abrahanlp/Nixie_Clock/Docu/reloj-nixie-proto-work.jpg

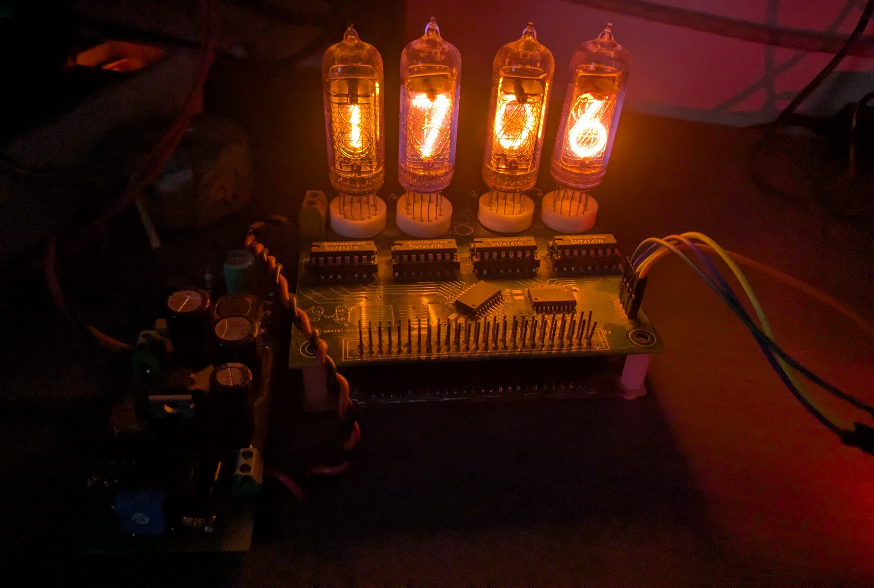
Docu/reloj-nixie-proto-work.jpg
