abrahanlp/Nixie_Clock/Docu/74141-and-nixies.jpg

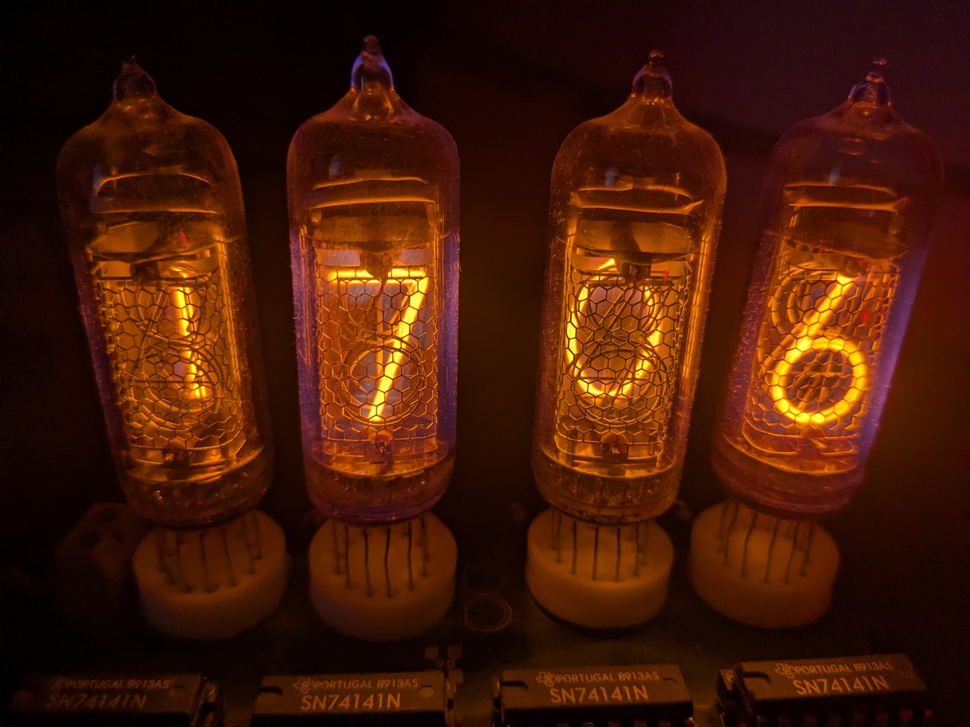
Docu/74141-and-nixies.jpg
