abrahanlp/Nixie_Clock/README.md

# Nixie_Clock
 Nixie display clock custom Arduino based.
