abrahanlp/Nixie_Clock/Docu/Nixie-Clock-diagram.png

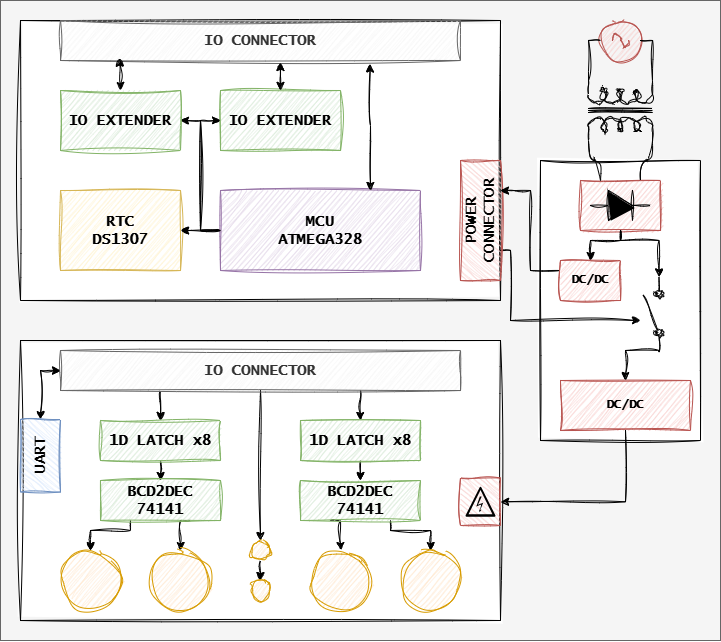
Docu/Nixie-Clock-diagram.png
