abrahanlp/Nixie_Clock/Hardware/MCU/MCU.brd

## EAGLE design Hardware/MCU/MCU.brd (2024-10-26)

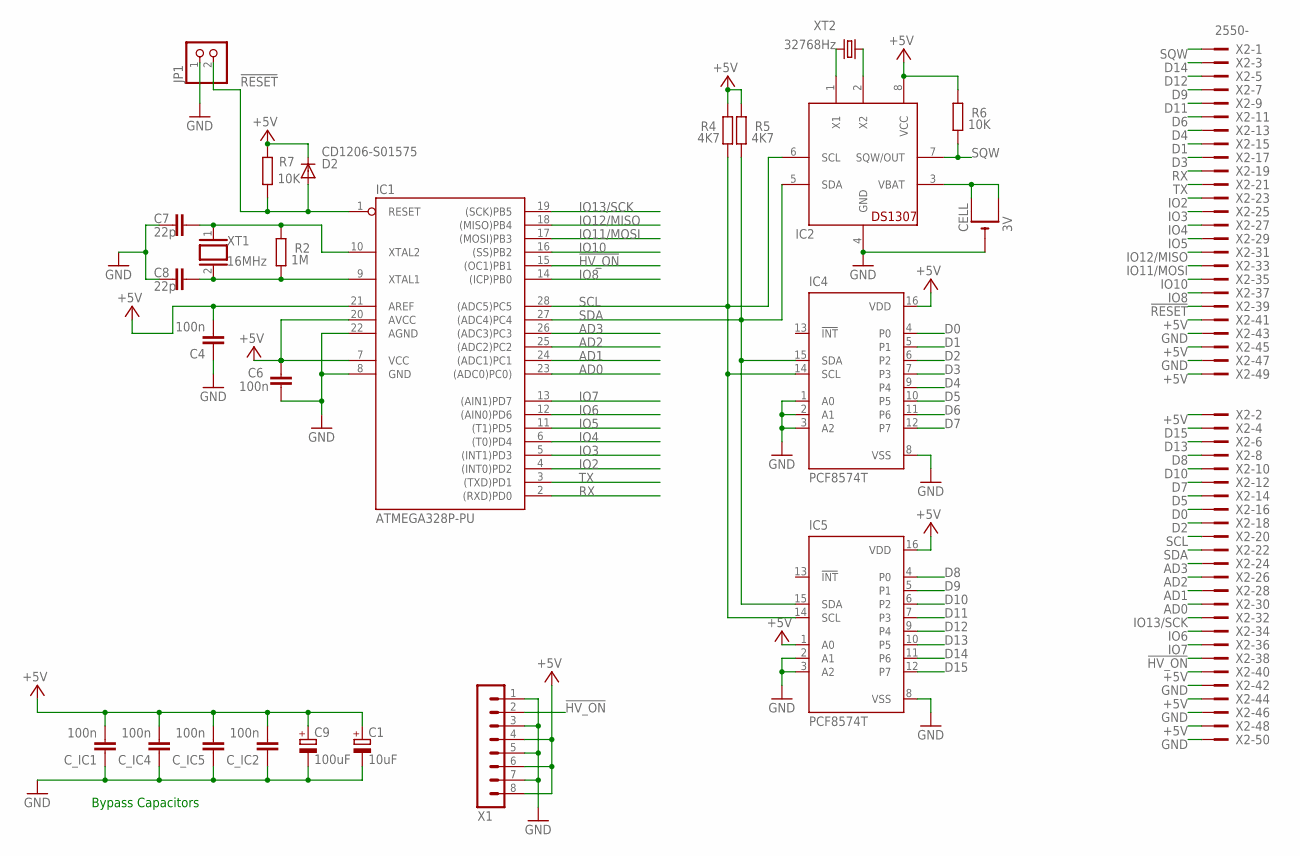
[picture p4: schematic MCU.sch]

Parts:
C1: 10uF; 085CS_1AR
C4, C6: 100n; C1206
C7, C8: 22p; C1206
C9: 100uF; E5-10,5
CELL: 3V; CR2032-THRU
C_IC1, C_IC2, C_IC4, C_IC5: 100n; C1206
D2: CD1206-S01575; DO41-10
IC1: ATMEGA328P-PU; DIL28-3
IC2: DS1307; DIL08
IC4, IC5: PCF8574T; SO16W
JP1: PINHD-1X2; 1X02
R2: 1M; M1206
R4, R5: 4K7; M1206
R6, R7: 10K; M1206
X1: MA08-1W
X2: 2550-; PAK100/2500-50
XT1: 16MHz; QS
XT2: 32768Hz; TC26H

Connections:
!HV_ON: IC1.15 ((OC1)PB1), X1.2, X2.38
!RESET: D2.A, IC1.1 (RESET), JP1.2, R7.1, X2.39
+5V: C1.+, C4.2, C6.2, C9.+, C_IC1.2, C_IC2.2, C_IC4.2, C_IC5.2, D2.C, IC1.7 (VCC), IC1.20 (AVCC), IC1.21 (AREF), IC2.8 (VCC), IC4.16 (VDD), IC5.1 (A0), IC5.16 (VDD), R4.2, R5.2, R6.2, R7.2, X1.4, X1.6, X1.8, X2.2, X2.40, X2.41, X2.44, X2.45, X2.48, X2.49
AD0: IC1.23 ((ADC0)PC0)), X2.30
AD1: IC1.24 ((ADC1)PC1), X2.28
AD2: IC1.25 ((ADC2)PC2), X2.26
AD3: IC1.26 ((ADC3)PC3), X2.24
D0: IC4.4 (P0), X2.16
D1: IC4.5 (P1), X2.15
D2: IC4.6 (P2), X2.18
D3: IC4.7 (P3), X2.17
D4: IC4.9 (P4), X2.13
D5: IC4.10 (P5), X2.14
D6: IC4.11 (P6), X2.11
D7: IC4.12 (P7), X2.12
D8: IC5.4 (P0), X2.8
D9: IC5.5 (P1), X2.7
D10: IC5.6 (P2), X2.10
D11: IC5.7 (P3), X2.9
D12: IC5.9 (P4), X2.5
D13: IC5.10 (P5), X2.6
D14: IC5.11 (P6), X2.3
D15: IC5.12 (P7), X2.4
GND: C1.-, C4.1, C6.1, C7.1, C8.1, C9.-, CELL.-, C_IC1.1, C_IC2.1, C_IC4.1, C_IC5.1, IC1.8 (GND), IC1.22 (AGND), IC2.4 (GND), IC4.1 (A0), IC4.2 (A1), IC4.3 (A2), IC4.8 (VSS), IC5.2 (A1), IC5.3 (A2), IC5.8 (VSS), JP1.1, X1.1, X1.3, X1.5, X1.7, X2.42, X2.43, X2.46, X2.47, X2.50
IO2: IC1.4 ((INT0)PD2), X2.23
IO3: IC1.5 ((INT1)PD3), X2.25
IO4: IC1.6 ((T0)PD4), X2.27
IO5: IC1.11 ((T1)PD5), X2.29
IO6: IC1.12 ((AIN0)PD6), X2.34
IO7: IC1.13 ((AIN1)PD7), X2.36
IO8: IC1.14 ((ICP)PB0), X2.37
IO10: IC1.16 ((SS)PB2), X2.35
IO11/MOSI: IC1.17 ((MOSI)PB3), X2.33
IO12/MISO: IC1.18 ((MISO)PB4), X2.31
IO13/SCK: IC1.19 ((SCK)PB5), X2.32
RX: IC1.2 ((RXD)PD0), X2.19
SCL: IC1.28 ((ADC5)PC5), IC2.6 (SCL), IC4.14 (SCL), IC5.14 (SCL), R4.1, X2.20
SDA: IC1.27 ((ADC4)PC4), IC2.5 (SDA), IC4.15 (SDA), IC5.15 (SDA), R5.1, X2.22
SQW: IC2.7 (SQW/OUT), R6.1, X2.1
TX: IC1.3 ((TXD)PD1), X2.21
VBAT: CELL.+1 (+), CELL.+2 (+1), IC2.3 (VBAT)
X1_RTC: IC2.1 (X1), XT2.2
X2_RTC: IC2.2 (X2), XT2.1
XTAL1: C8.2, IC1.9 (XTAL1), R2.1, XT1.2
XTAL2: C7.2, IC1.10 (XTAL2), R2.2, XT1.1

Notes on the sheet:
Bypass Capacitors

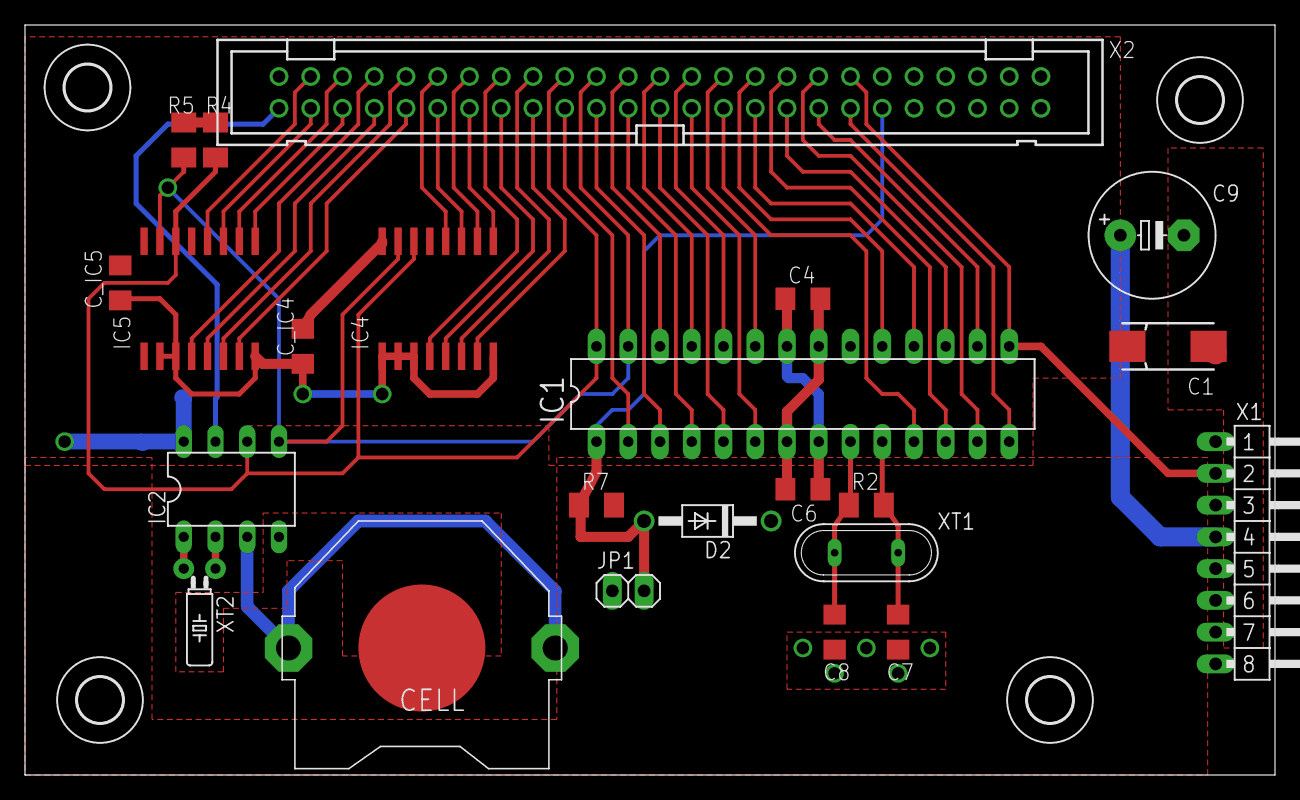
[picture p5: board MCU.brd from above]

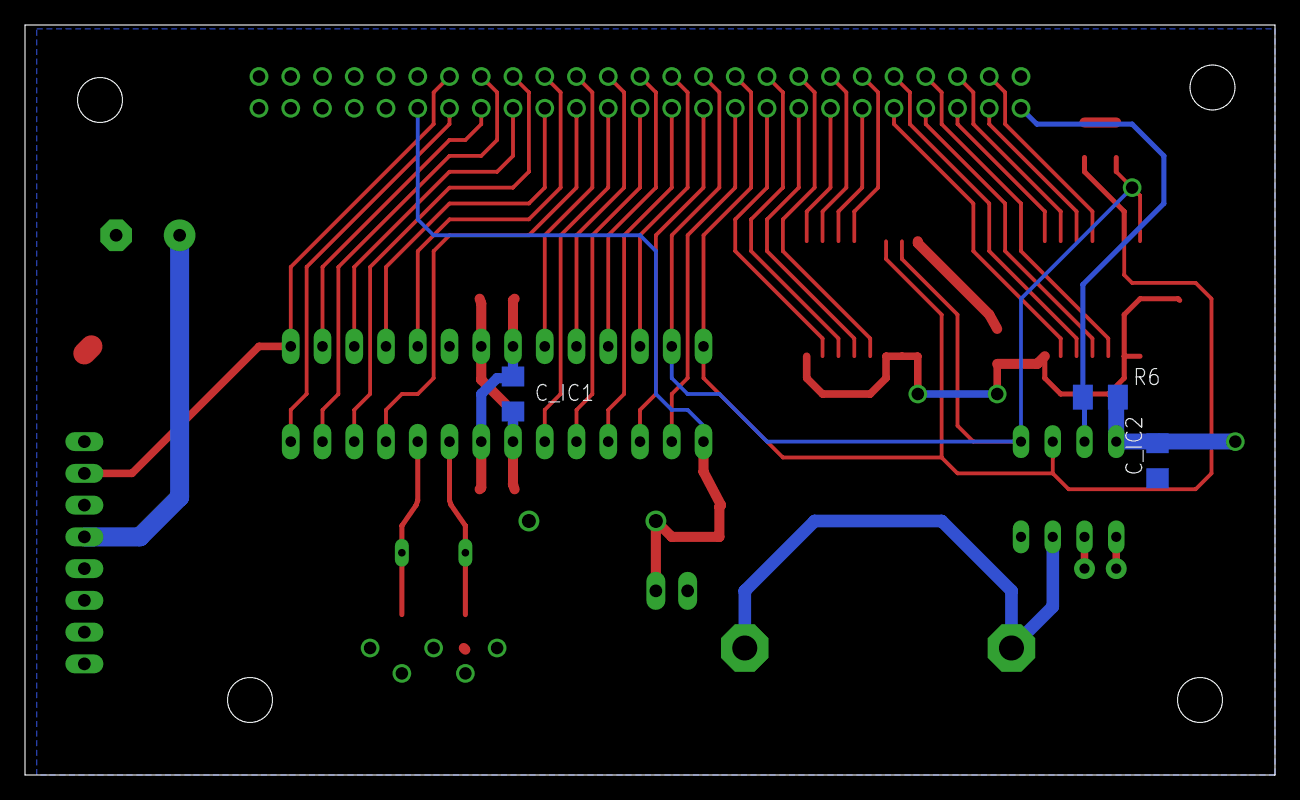
[picture p6: board MCU.brd from below]

Board: 2 copper layers, 100.0 x 60.0 mm, 30 parts (3 on the bottom side), 45 nets.

Other parts of the board:
U$1, U$2, U$3, U$4: 3,6
