abrahanlp/Nixie_Clock/Hardware/NixieDriver/NixieDriver.brd

## EAGLE design Hardware/NixieDriver/NixieDriver.brd (2024-08-15)

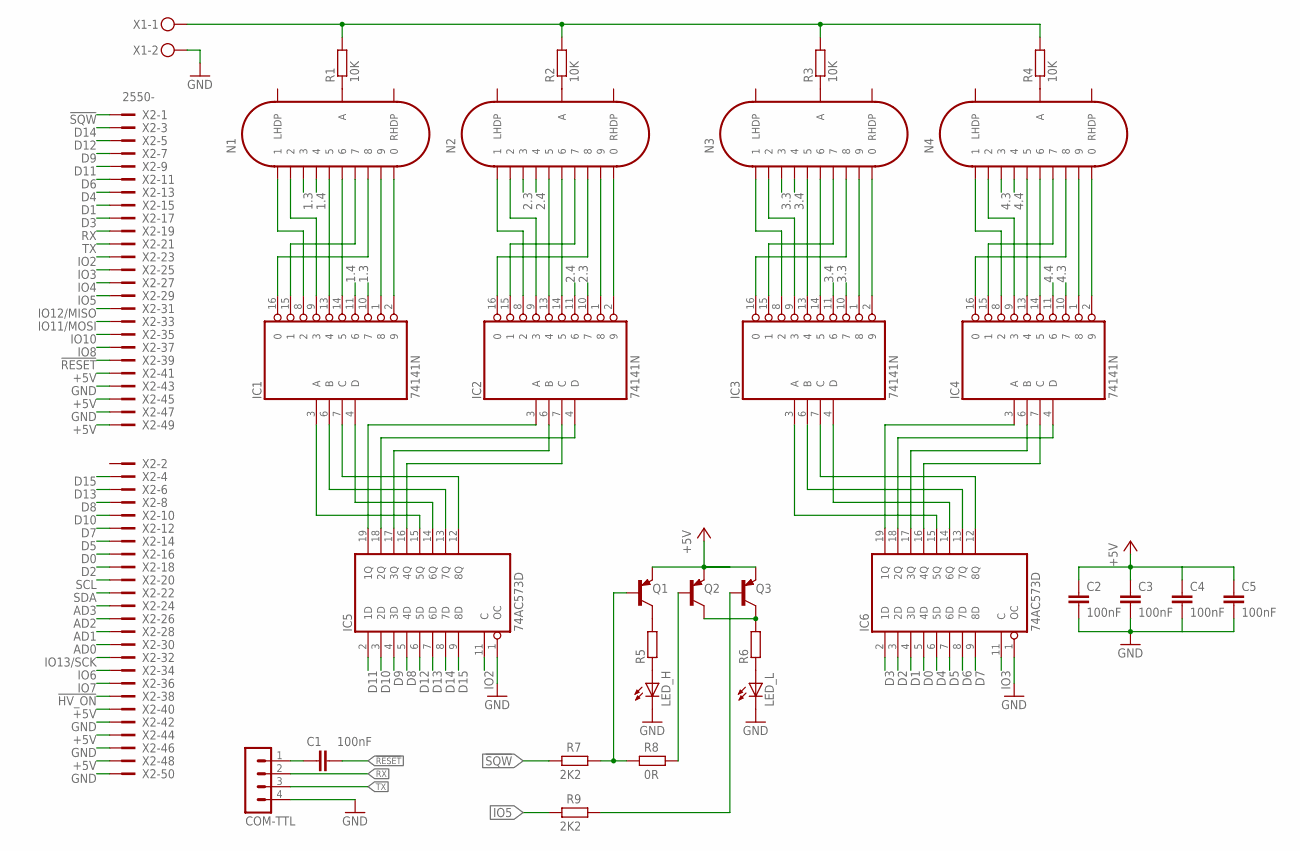
[picture p7: schematic NixieDriver.sch]

Parts:
C1, C2, C3, C4, C5: 100nF; C1210
COM-TTL: MA04-1
IC1, IC2, IC3, IC4: 74141N; DIL16
IC5, IC6: 74AC573D; SO20W
LED_H: LED5MM
LED_L: LED5MM
N1, N2, N3, N4: IN-14
Q1, Q2, Q3: BF621-PNP-SOT98-BCE; SOT89-BCE
R1, R2, R3, R4: 10K; 0309V
R5, R6: R-EU_M1206; M1206
R7: 2K2; M1406
R8: 0R; M1406
R9: 2K2; M1206
X1: MKDSN1,5/2-5,08
X2: 2550-; PAK100/2500-50

Connections:
1.0: IC1.2 (9), N1.0
1.1: IC1.8 (2), N1.1
1.2: IC1.9 (3), N1.2
1.3: IC1.10 (7), N1.3
1.4: IC1.11 (6), N1.4
1.5: IC1.13 (4), N1.5
1.6: IC1.14 (5), N1.6
1.7: IC1.15 (1), N1.7
1.8: IC1.16 (0), N1.8
1.9: IC1.1 (8), N1.9
2.0: IC2.2 (9), N2.0
2.1: IC2.8 (2), N2.1
2.2: IC2.9 (3), N2.2
2.3: IC2.10 (7), N2.3
2.4: IC2.11 (6), N2.4
2.5: IC2.13 (4), N2.5
2.6: IC2.14 (5), N2.6
2.7: IC2.15 (1), N2.7
2.8: IC2.16 (0), N2.8
2.9: IC2.1 (8), N2.9
3.0: IC3.2 (9), N3.0
3.1: IC3.8 (2), N3.1
3.2: IC3.9 (3), N3.2
3.3: IC3.10 (7), N3.3
3.4: IC3.11 (6), N3.4
3.5: IC3.13 (4), N3.5
3.6: IC3.14 (5), N3.6
3.7: IC3.15 (1), N3.7
3.8: IC3.16 (0), N3.8
3.9: IC3.1 (8), N3.9
4.0: IC4.2 (9), N4.0
4.1: IC4.8 (2), N4.1
4.2: IC4.9 (3), N4.2
4.3: IC4.10 (7), N4.3
4.4: IC4.11 (6), N4.4
4.5: IC4.13 (4), N4.5
4.6: IC4.14 (5), N4.6
4.7: IC4.15 (1), N4.7
4.8: IC4.16 (0), N4.8
4.9: IC4.1 (8), N4.9
!HV_ON: X2.38
!RESET: C1.2, X2.39
!SQW: R7.2, X2.1
+5V: C2.1, C3.1, C4.1, C5.1, IC1.5 (VCC), IC2.5 (VCC), IC3.5 (VCC), IC4.5 (VCC), IC5.20 (VCC), IC6.20 (VCC), Q1.E, Q2.E, Q3.E, X2.40, X2.41, X2.44, X2.45, X2.48, X2.49
AD0: X2.30
AD1: X2.28
AD2: X2.26
AD3: X2.24
D0: IC6.5 (4D), X2.16
D1: IC6.4 (3D), X2.15
D2: IC6.3 (2D), X2.18
D3: IC6.2 (1D), X2.17
D4: IC6.6 (5D), X2.13
D5: IC6.7 (6D), X2.14
D6: IC6.8 (7D), X2.11
D7: IC6.9 (8D), X2.12
D8: IC5.5 (4D), X2.8
D9: IC5.4 (3D), X2.7
D10: IC5.3 (2D), X2.10
D11: IC5.2 (1D), X2.9
D12: IC5.6 (5D), X2.5
D13: IC5.7 (6D), X2.6
D14: IC5.8 (7D), X2.3
D15: IC5.9 (8D), X2.4
GND: C2.2, C3.2, C4.2, C5.2, COM-TTL.4, IC1.12 (GND), IC2.12 (GND), IC3.12 (GND), IC4.12 (GND), IC5.1 (OC), IC5.10 (GND), IC6.1 (OC), IC6.10 (GND), LED_H.K (C), LED_L.K (C), X1.2, X2.42, X2.43, X2.46, X2.47, X2.50
HIGH_VOLTAGE: R1.2, R2.2, R3.2, R4.2, X1.1
IO2: IC5.11 (C), X2.23
IO3: IC6.11 (C), X2.25
IO4: X2.27
IO5: R9.2, X2.29
IO6: X2.34
IO7: X2.36
IO8: X2.37
IO10: X2.35
IO11/MOSI: X2.33
IO12/MISO: X2.31
IO13/SCK: X2.32
unnamed: IC2.3 (A), IC5.19 (1Q)
unnamed: IC2.4 (D), IC5.18 (2Q)
unnamed: IC2.6 (B), IC5.17 (3Q)
unnamed: IC2.7 (C), IC5.16 (4Q)
unnamed: IC1.3 (A), IC5.15 (5Q)
unnamed: IC1.4 (D), IC5.14 (6Q)
unnamed: IC1.6 (B), IC5.13 (7Q)
unnamed: IC1.7 (C), IC5.12 (8Q)
unnamed: IC4.3 (A), IC6.19 (1Q)
unnamed: IC4.4 (D), IC6.18 (2Q)
unnamed: IC4.6 (B), IC6.17 (3Q)
unnamed: IC4.7 (C), IC6.16 (4Q)
unnamed: IC3.3 (A), IC6.15 (5Q)
unnamed: IC3.4 (D), IC6.14 (6Q)
unnamed: IC3.6 (B), IC6.13 (7Q)
unnamed: IC3.7 (C), IC6.12 (8Q)
unnamed: Q1.C, R5.2
unnamed: LED_H.A, R5.1
unnamed: Q2.C, Q3.C, R6.2
unnamed: LED_L.A, R6.1
unnamed: Q1.B, R7.1, R8.2
unnamed: C1.1, COM-TTL.1
unnamed: Q2.B, R8.1
unnamed: N1.A, R1.1
unnamed: N2.A, R2.1
unnamed: N3.A, R3.1
unnamed: N4.A, R4.1
unnamed: Q3.B, R9.1
RX: COM-TTL.2, X2.19
SCL: X2.20
SDA: X2.22
TX: COM-TTL.3, X2.21

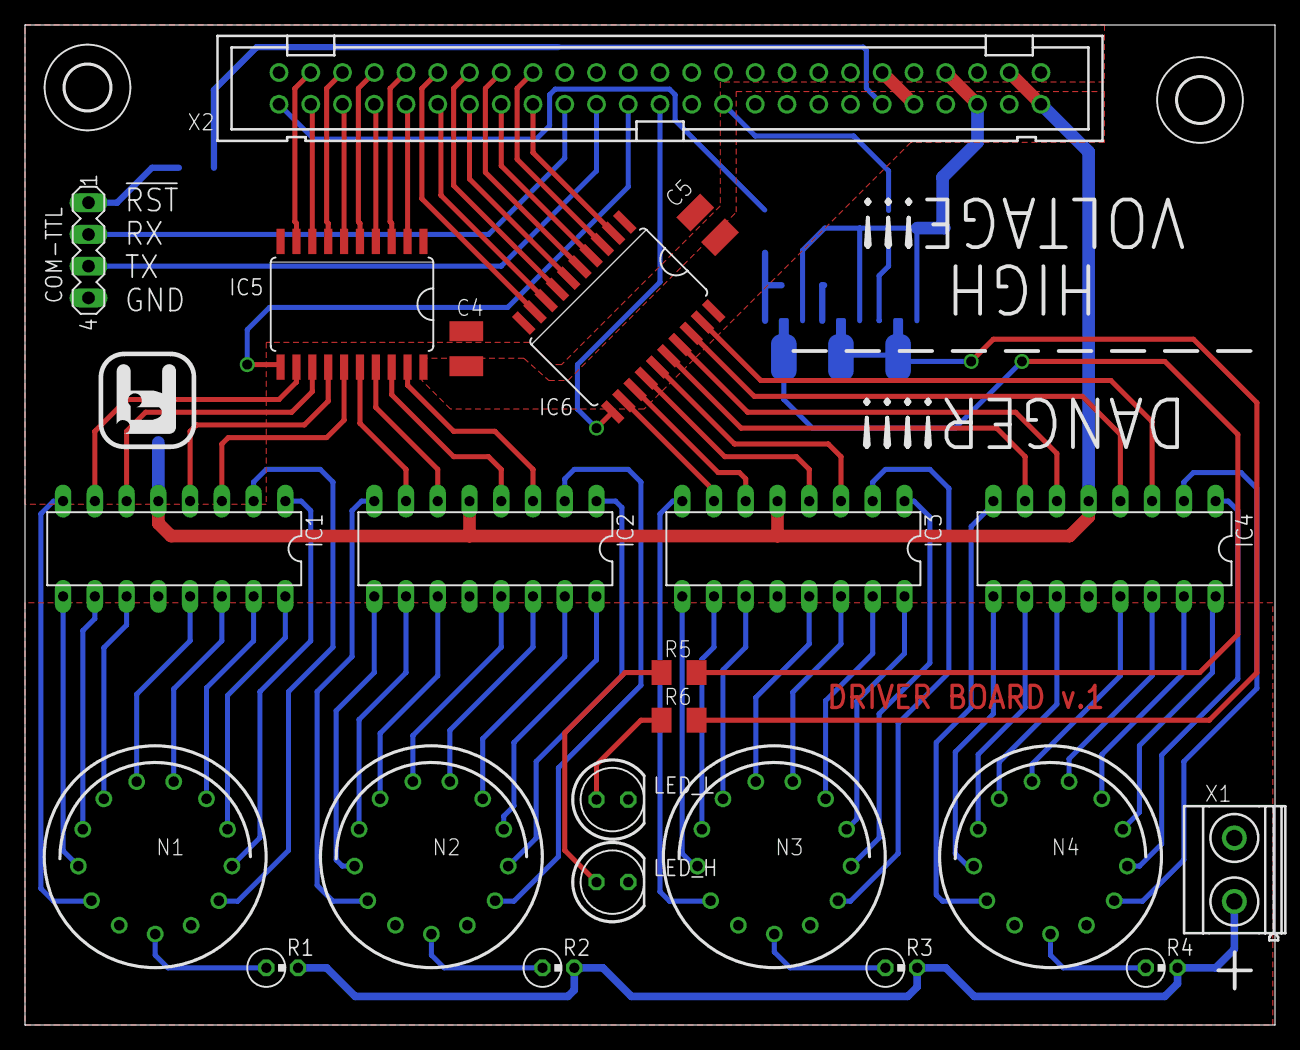
[picture p8: board NixieDriver.brd from above]

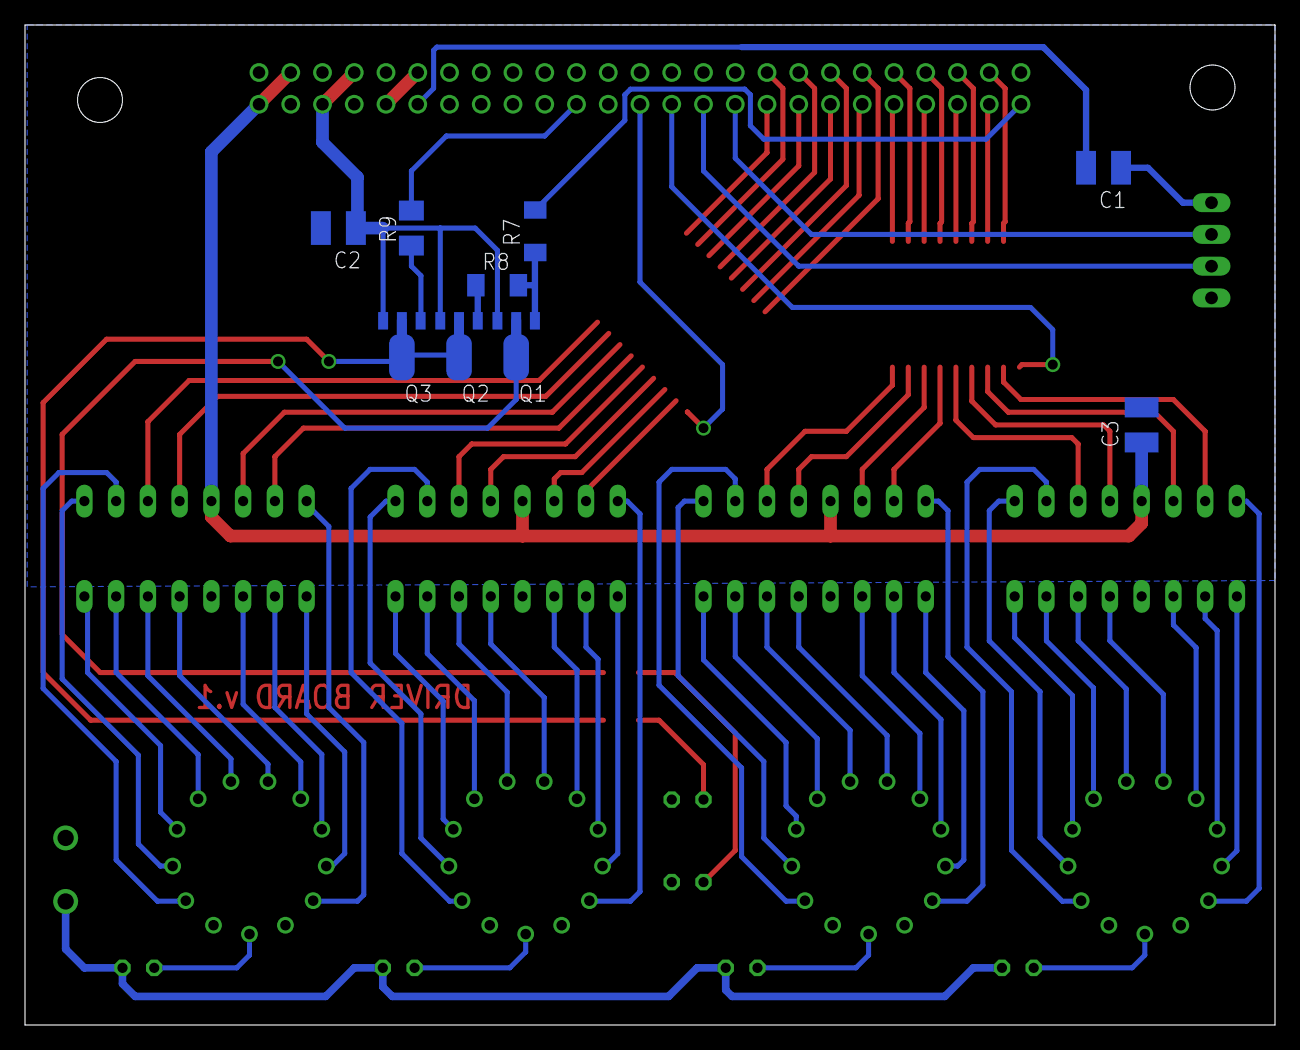
[picture p9: board NixieDriver.brd from below]

Board: 2 copper layers, 100.0 x 80.0 mm, 34 parts (9 on the bottom side), 94 nets.

Other parts of the board:
U$1, U$3: 3,6
