abrahanlp/Nixie_Clock/Hardware/Fuente Alimentación/Fuente Alimentación.brd

## EAGLE design Hardware/Fuente Alimentación/Fuente Alimentación.brd (2024-08-14)

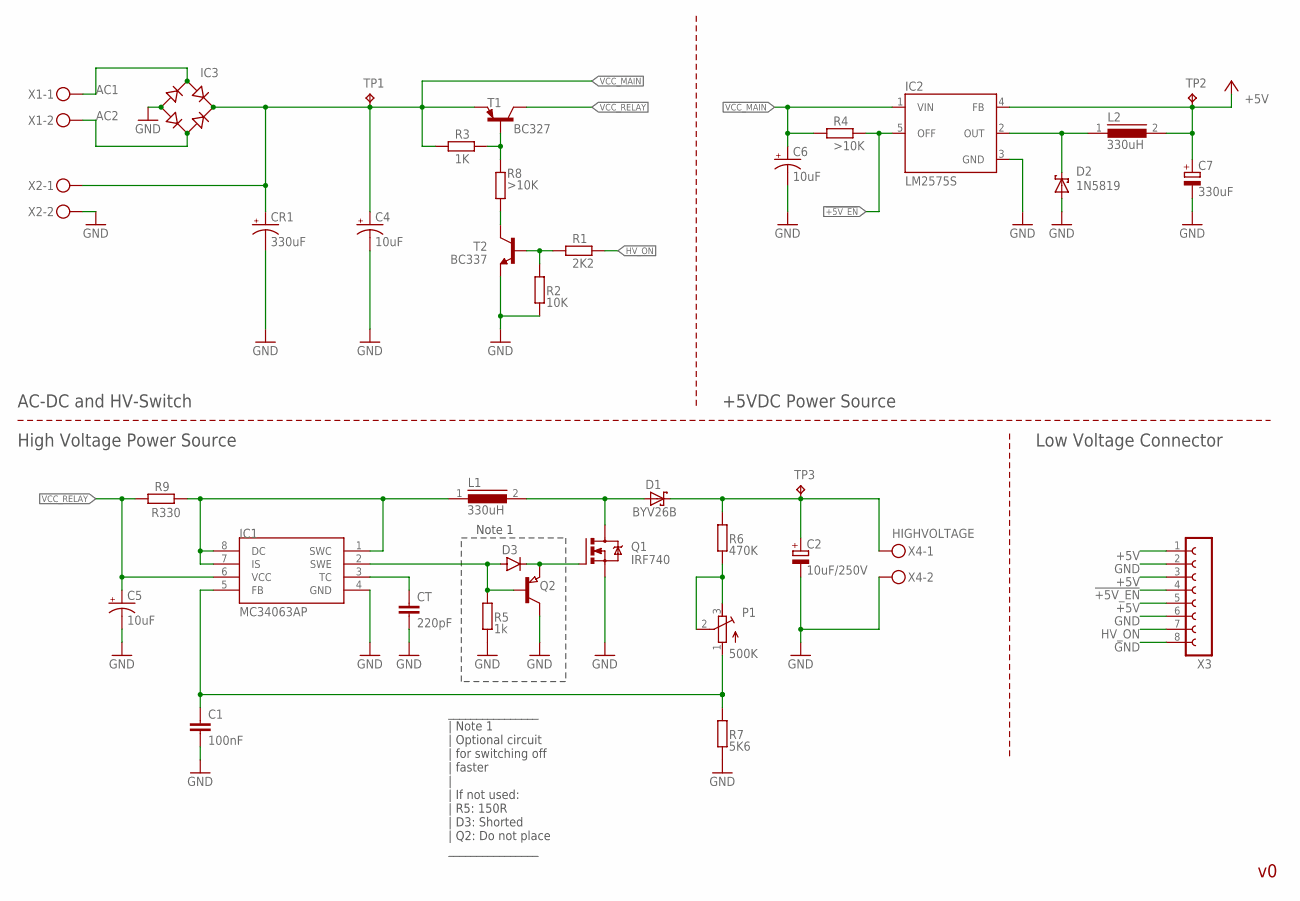
[picture p10: schematic Fuente Alimentación.sch]

Parts:
C1: 100nF; C1808
C2: 10uF/250V; E5-13
C4, C5, C6: 10uF; 085CS_1AR
C7: 330uF; E5-10,5
CR1: 330uF; E5-13
CT: 220pF; C025-024X044
D1: BYV26B; DO41-7.6
D2: 1N5819; DO41-7.6
D3: MBR0520LT; SOD123
IC1: MC34063AP; DIL08
IC2: LM2575S; TO263-5
IC3: B-DIL
L1, L2: 330uH; DR125
P1: 500K; RTRIM64W
Q1: IRF740; TO220BV
Q2: PNP-TRANSISTOR_SOT23; SOT23
R1: 2K2; 0207/2V
R2: 10K; 0207/2V
R3: 1K; 0204/5
R4: >10K; 0207/2V
R5: 1k; 0204V
R6: 470K; 0204/7
R7: 5K6; 0204V
R8: >10K; 0204V
R9: R330; 0204V
T1: BC327; TO92
T2: BC337; TO92
TP1, TP2, TP3: TPB1,27; B1,27
X1, X2, X4: MKDSN1,5/2-5,08
X3: FE08W

Connections:
!+5V_EN: IC2.5 (OFF), R4.2, X3.4
+5V: C7.+, IC2.4 (FB), L2.2, TP2.TP, X3.1, X3.3, X3.5
AC1: IC3.AC2, X1.1
AC2: IC3.AC1, X1.2
CT: CT.1, IC1.3 (TC)
GND: C1.2, C2.-, C4.-, C5.-, C6.-, C7.-, CR1.-, CT.2, D2.A, IC1.4 (GND), IC2.3 (GND), IC3.-, Q1.S, Q2.3 (C), R2.1, R5.1, R7.1, T2.1 (E), X2.2, X3.2, X3.6, X3.8, X4.2
HIGHVOLTAGE: C2.+, D1.C, R6.2, TP3.TP, X4.1
HV_ON: R1.2, X3.7
unnamed: D3.C, Q1.G, Q2.2 (E)
unnamed: C1.1, IC1.5 (FB), P1.1 (A), R7.2
unnamed: D2.C, IC2.2 (OUT), L2.1
unnamed: D1.A, L1.2, Q1.D
unnamed: P1.2 (S), P1.3 (E), R6.1
unnamed: IC1.1 (SWC), IC1.7 (IS), IC1.8 (DC), L1.1, R9.2
unnamed: R3.2, R8.2, T1.2 (B)
unnamed: R1.1, R2.2, T2.2 (B)
unnamed: R8.1, T2.3 (C)
SWE: D3.A, IC1.2 (SWE), Q2.1 (B), R5.2
VCC_MAIN: C4.+, C6.+, CR1.+, IC2.1 (VIN), IC3.+, R3.1, R4.1, T1.1 (E), TP1.TP, X2.1
VCC_RELAY: C5.+, IC1.6 (VCC), R9.1, T1.3 (C)

Notes on the sheet:
________________ | Note 1 | Optional circuit | for switching off | faster | | If not used: | R5: 150R | D3: Shorted | Q2: Do not place ________________
Note 1
AC-DC and HV-Switch
+5VDC Power Source
High Voltage Power Source
Low Voltage Connector

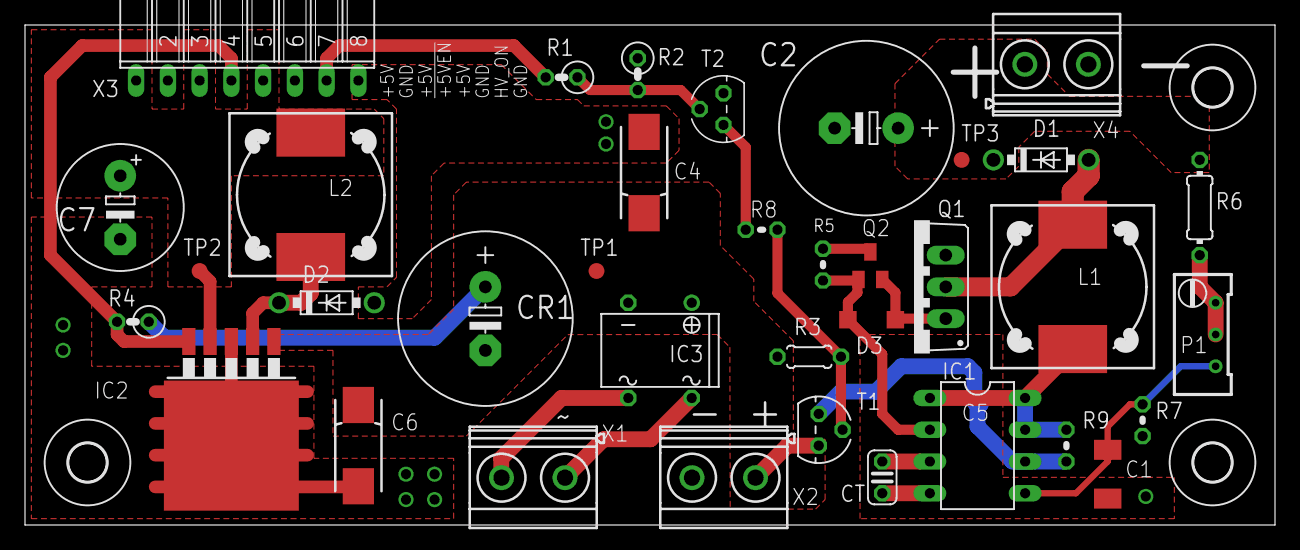
[picture p11: board Fuente Alimentación.brd from above]

Board: 2 copper layers, 100.0 x 40.0 mm, 40 parts (1 on the bottom side), 20 nets.

Other parts of the board:
U$1, U$2, U$3: 3,0
