abrahanlp/Nixie_Clock/(commit log)

2024-08-14 Updated schematics.
    [Fuente Alimentación.brd, Fuente Alimentación.sch, MCU.brd, MCU.sch, NixieDriver.brd, NixieDriver.sch]
2024-08-15 Driver board fixes
    Added bypass capacitors.
    Power layout modified.
    [NixieDriver.brd, NixieDriver.sch]
2024-08-18 RTC basic driver.
2024-08-18 Basic nixie driver, do not work.
    [Nixie.ino, nixie_driver.cpp, nixie_driver.h]
2024-08-31 Basic Nixie driver
2024-08-31 Fixed nixie driver schematics, wrong order.
    [NixieDriver.sch]
2024-10-12 WDT enabled. Minimal error management.
    [Nixie.ino, nixie_driver.cpp, nixie_driver.h]
2024-10-13 Wire is initialized on setup(). RTC functions to manage SQW pin.
2024-10-26 SQW pull-up to VCC, not cell. EMI PCB layout improvements.
    [MCU.brd, MCU.sch]
2025-03-28 Added prototype images
